Gynju/WietrznaTuba/pictures/18B20.jpg

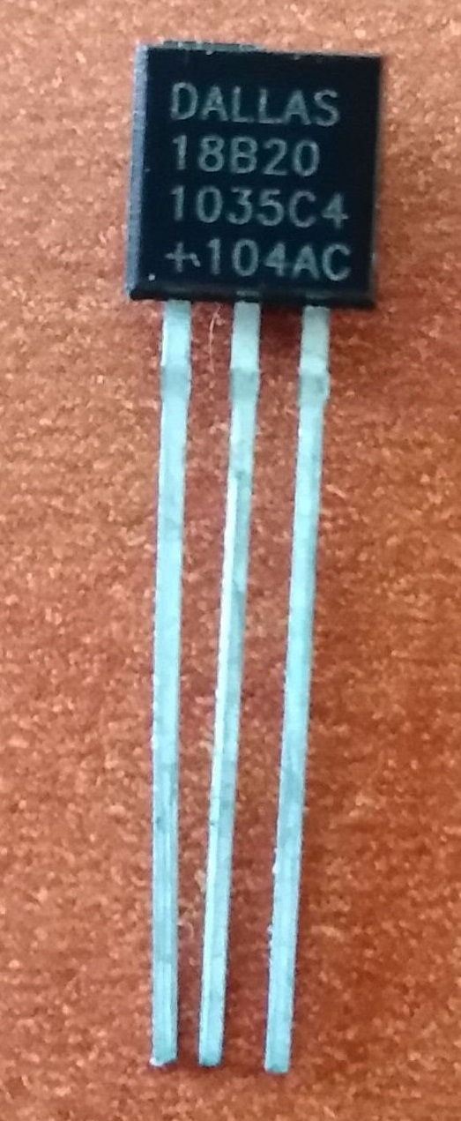
pictures/18B20.jpg
