Gynju/WietrznaTuba/pictures/RF520.jpg

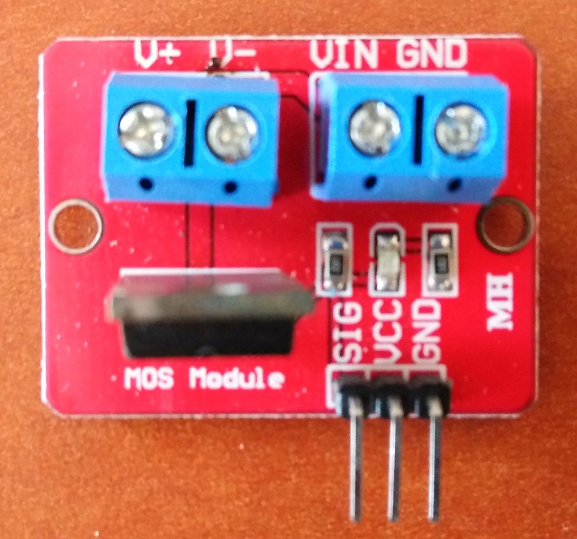
pictures/RF520.jpg
