Gynju/WietrznaTuba/pictures/arduino.jpg

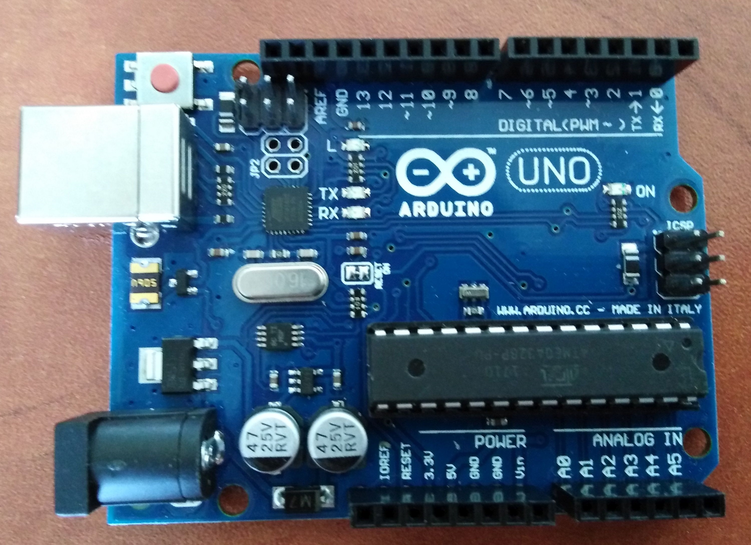
pictures/arduino.jpg
