Gynju/WietrznaTuba/pictures/controlPanel.png

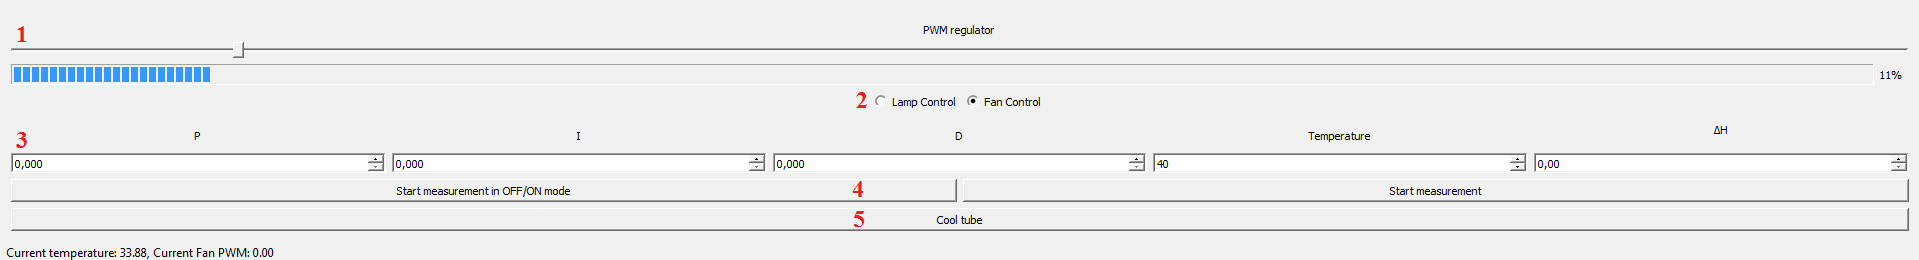
pictures/controlPanel.png
