Gynju/WietrznaTuba/pictures/dampedOscillations.png

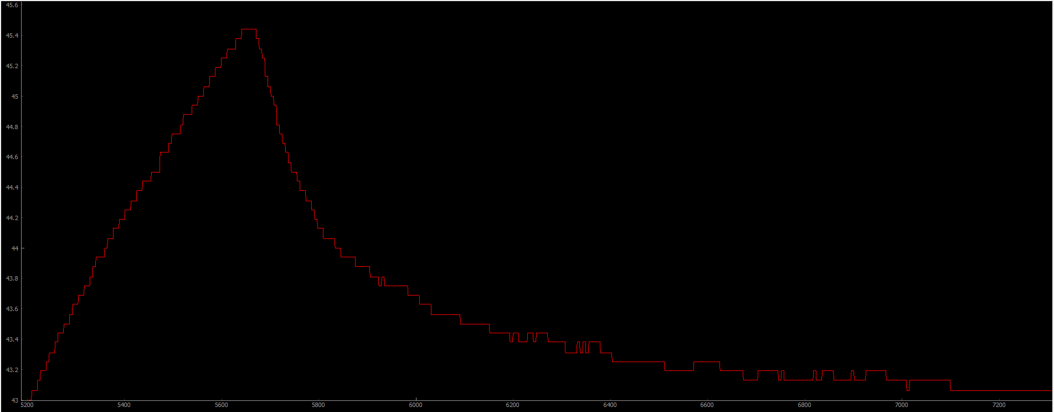
pictures/dampedOscillations.png
