Gynju/WietrznaTuba/pictures/exportDanych.png

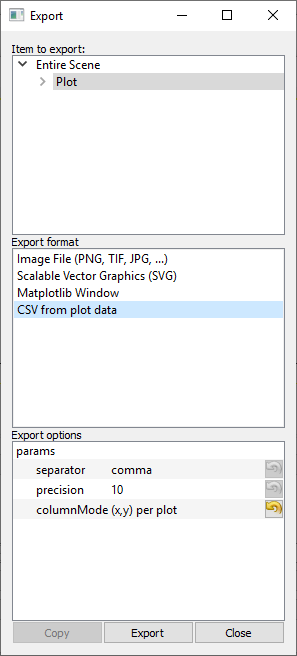
pictures/exportDanych.png
