Gynju/WietrznaTuba/pictures/fan.jpg

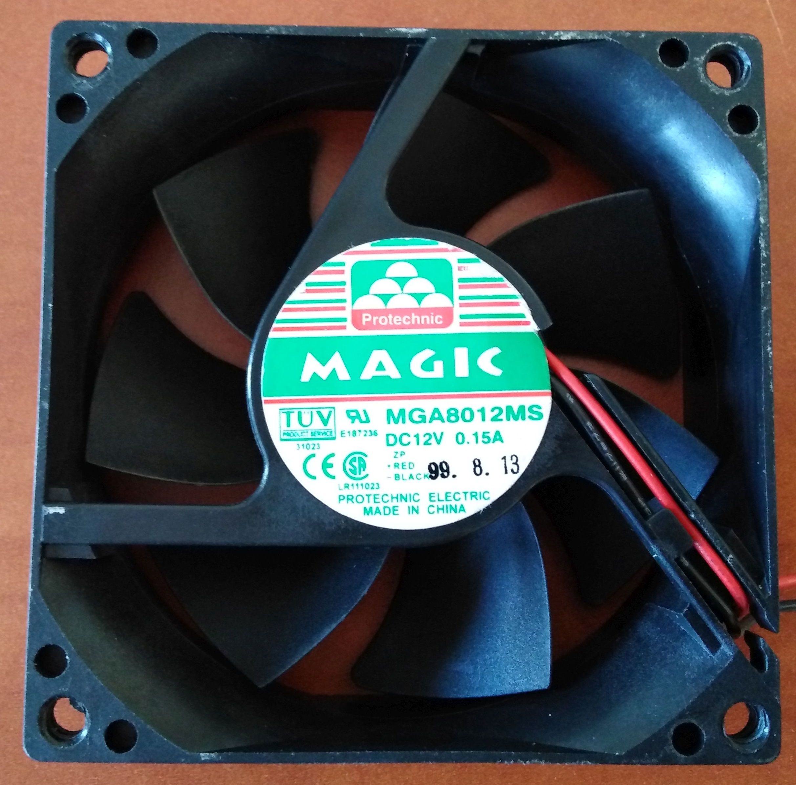
pictures/fan.jpg
