Gynju/WietrznaTuba/pictures/firstFinal.png

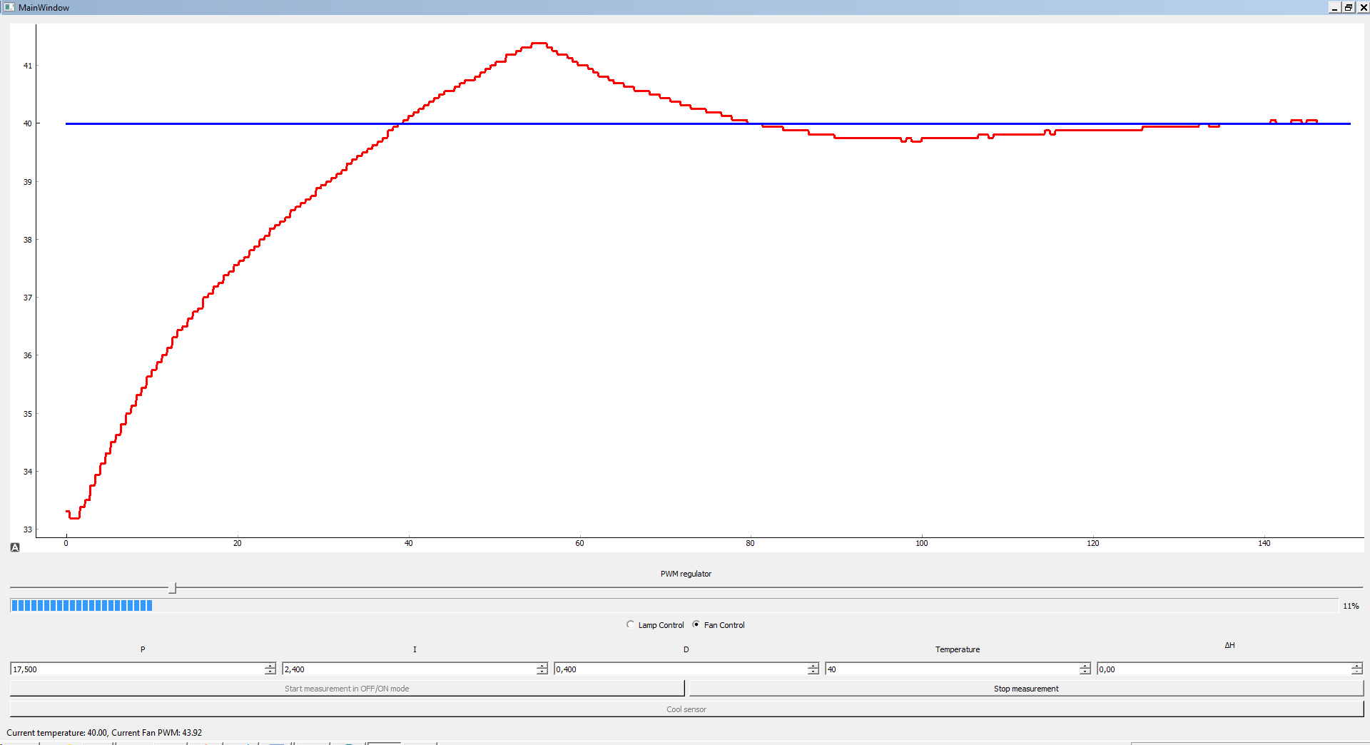
pictures/firstFinal.png
