Gynju/WietrznaTuba/pictures/LM35.jpg

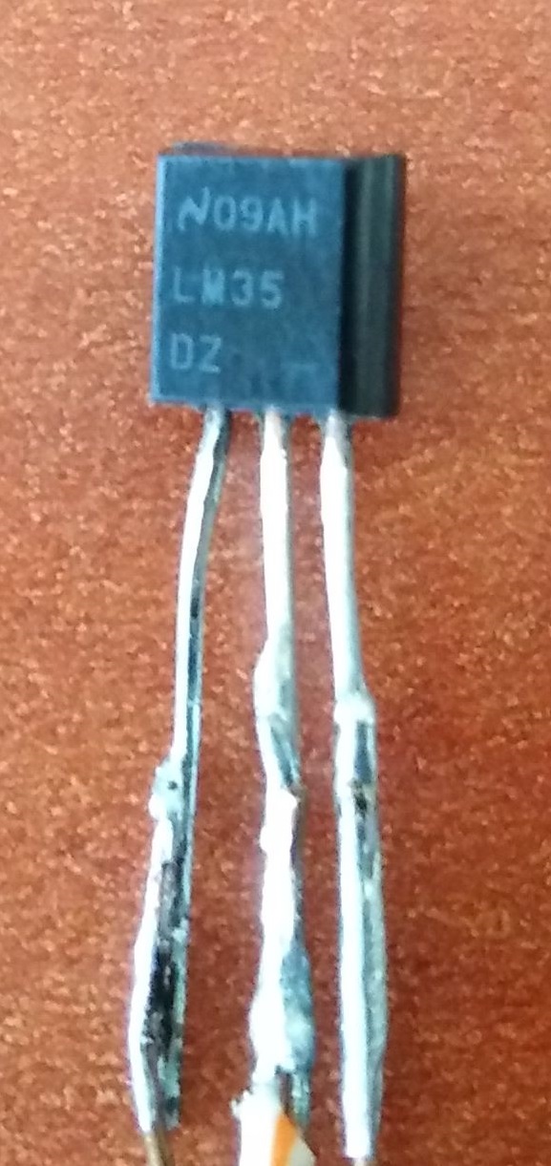
pictures/LM35.jpg
