Gynju/WietrznaTuba/pictures/oscillations2.png

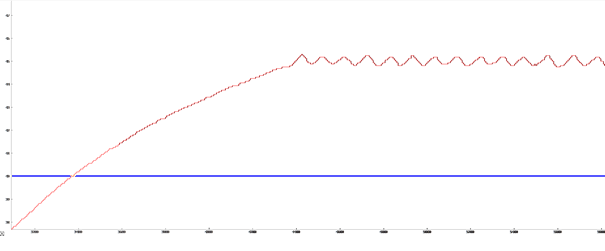
pictures/oscillations2.png
