Gynju/WietrznaTuba/pictures/oscillations.png

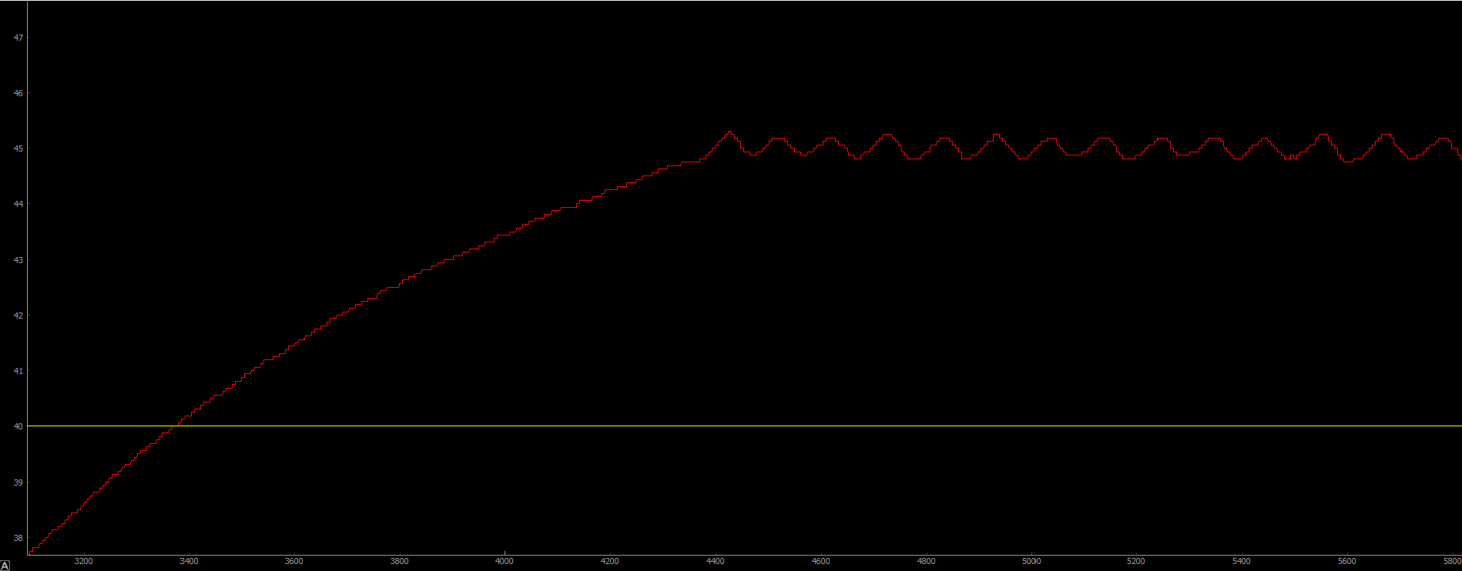
pictures/oscillations.png
