Gynju/WietrznaTuba/pictures/regulatorDwustanowy.png

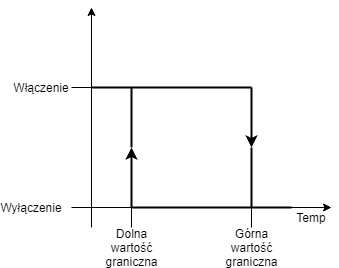
pictures/regulatorDwustanowy.png
