Gynju/WietrznaTuba/pictures/secondFinal.png

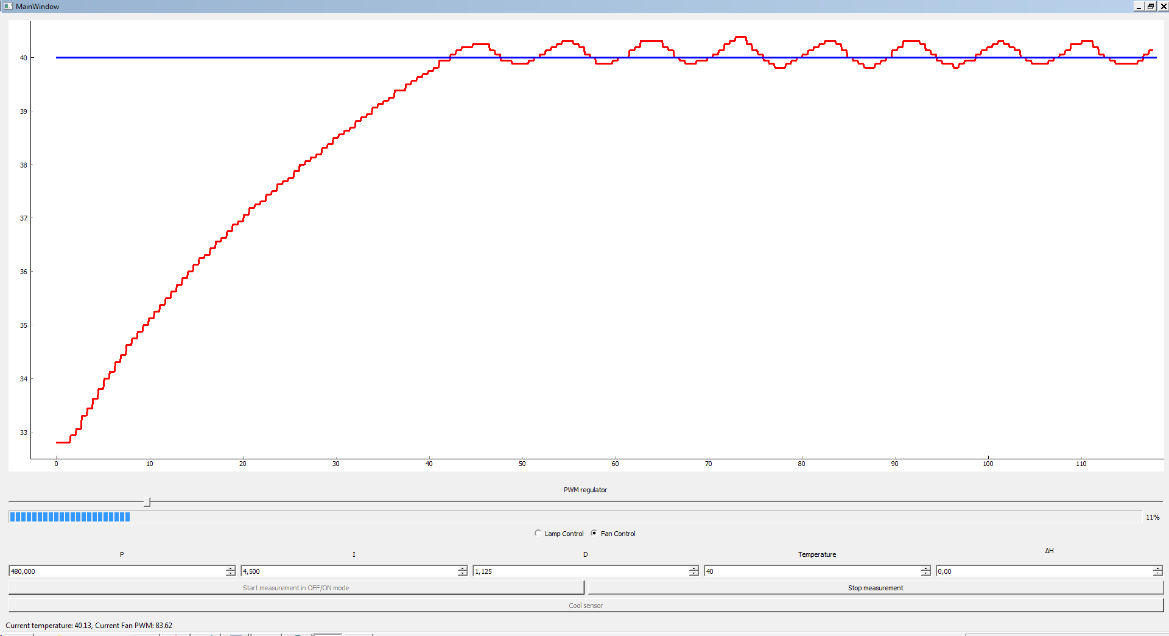
pictures/secondFinal.png
