Gynju/WietrznaTuba/pictures/system schematics.png

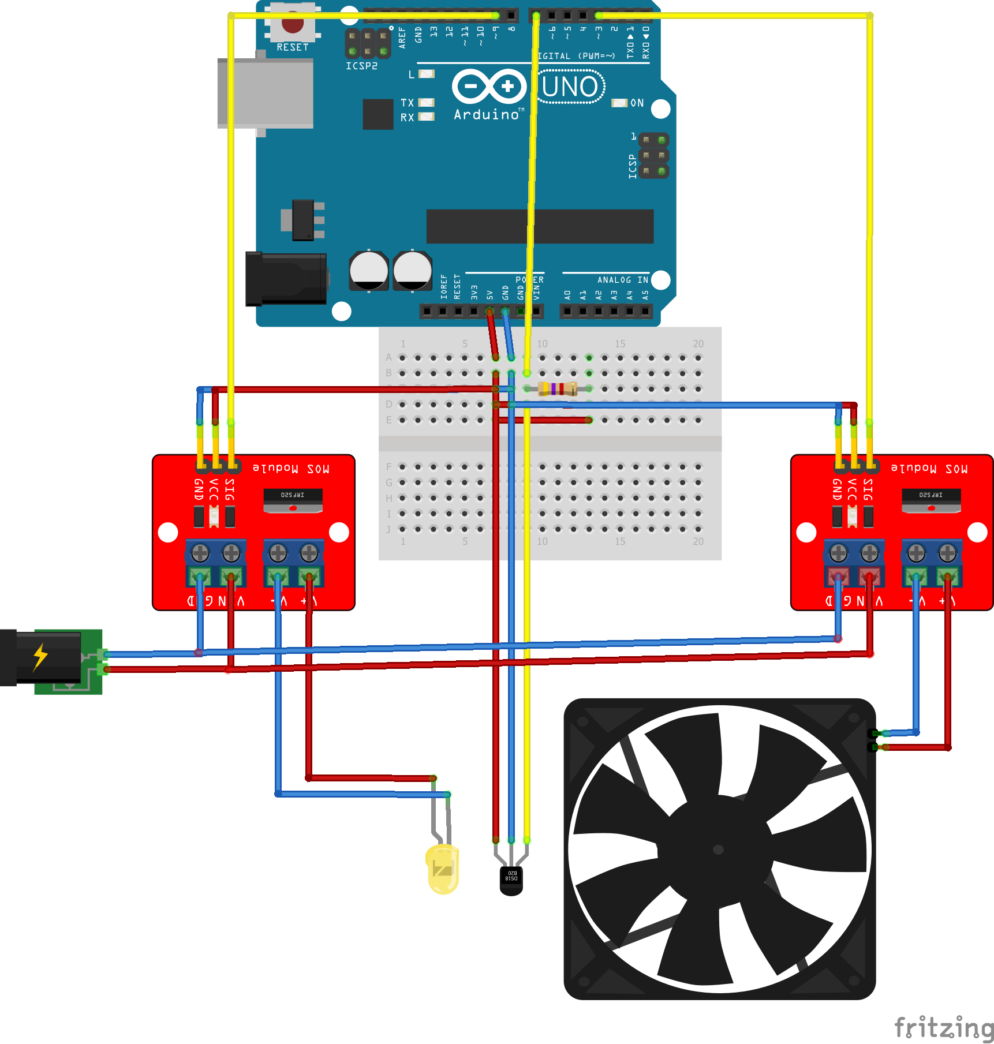
pictures/system schematics.png
