Gynju/WietrznaTuba/pictures/system.jpg

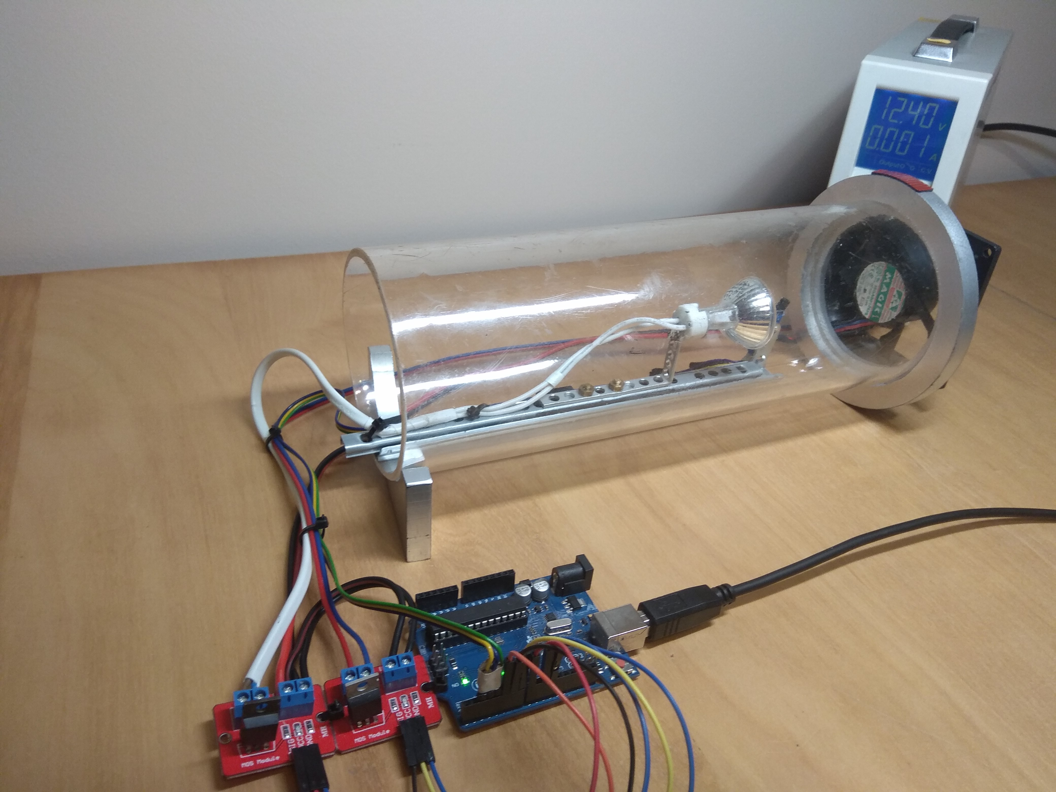
pictures/system.jpg
