Gynju/WietrznaTuba/pictures/Uklad-diagram.png

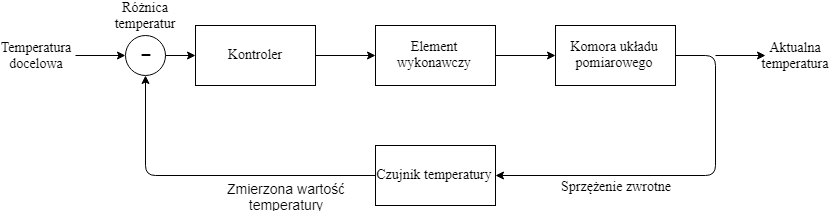
pictures/Uklad-diagram.png
