Gynju/WietrznaTuba/pictures/Uklad-diagram_2.png

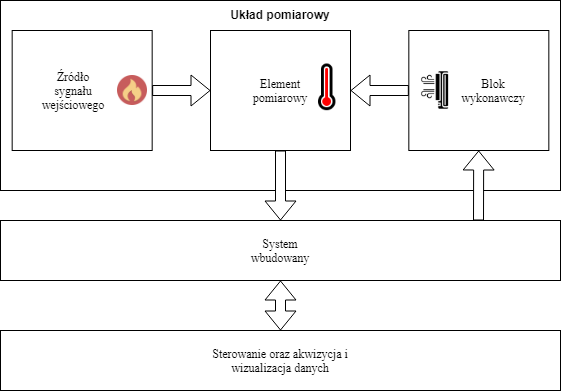
pictures/Uklad-diagram_2.png
