Gynju/WietrznaTuba/pictures/window.png

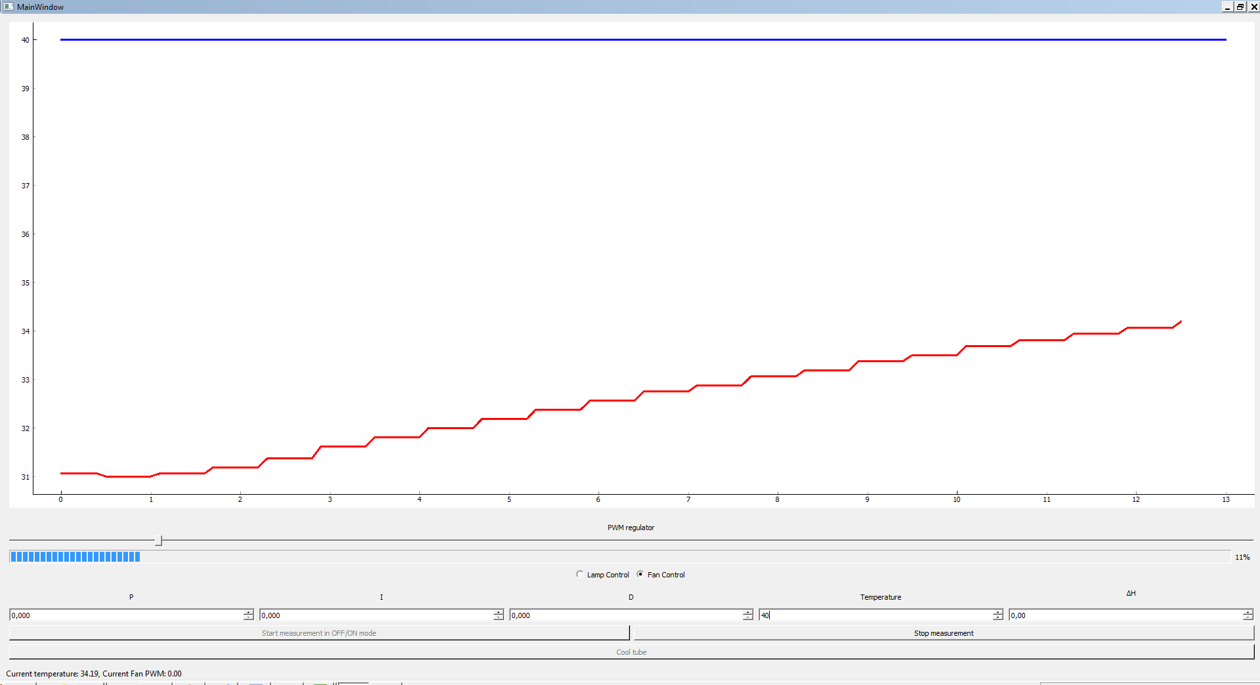
pictures/window.png
