Gynju/WietrznaTuba/pictures/zieglerFirst.png

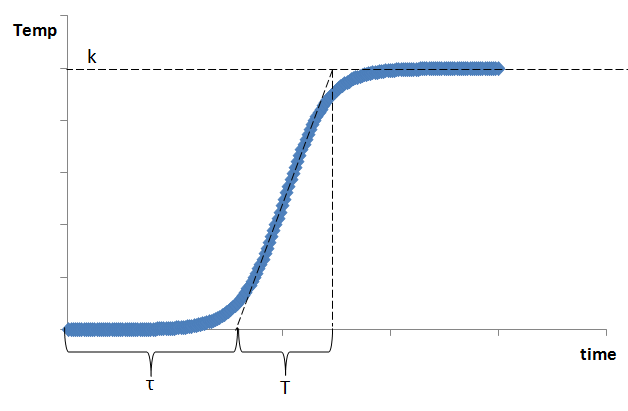
pictures/zieglerFirst.png
