Gynju/WietrznaTuba/(commit log)

2018-11-06 Cleared arduino code a little
2018-11-06 Added libraries used by arduino code
2018-12-04 Passing values to arduino is working
2018-12-05 Sending data to arduino is working properly
2018-12-12 WORKING THREADS!
2018-12-19 Working PWM bar, temperature status
2019-02-21 Another day, another changes
    [sampleData.csv]
2019-02-22 Final Countdown
    [Zeszyt1.xls, abc.csv]
